thuongton999/openarm/apps/firmware/firmware.ioc

Mcu.UserName=STM32F103C8Tx
PA11.Signal=USB_DM
PA12.Signal=USB_DP
PA13.Signal=SYS_JTMS-SWDIO
PA14.Signal=SYS_JTCK-SWCLK
PB3.Signal=SYS_JTDO-TRACESWO
PB6.Signal=I2C1_SCL
PB7.Signal=I2C1_SDA
PC13-TAMPER-RTC.Signal=GPIO_Output
PD0-OSC_IN.Signal=RCC_OSC_IN
PD1-OSC_OUT.Signal=RCC_OSC_OUT
