thuongton999/openarm/(commit log)

2025-10-15 feat(joints): Enhance reset functionality to update robot model and send angles; refactor UI by removing unnecessary gap in ConnectButton
2025-10-15 chore(docs): Remove ENVIRONMENT_SETUP.md and add README.md for project overview, features, setup instructions, and deployment details; update CAD README for credential setup reference.
2025-10-30 feat(firmware): Add initial firmware structure with DMA, GPIO, I2C, and USB device support; include FreeRTOS configuration and protocol handling; update webconnect with new proto definitions and remo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
2025-11-05 feat(firmware): Implement PCA9685 PWM driver and Protocol Buffers integration for servo control; add FreeRTOS task management for command processing and safety monitoring; enhance USB CDC communicati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
2025-11-06 feat(firmware): Add servo channel definitions and implement varint decoding for protocol messages; refactor servo control tasks for improved clarity and safety monitoring.
2025-11-06 docs(README): Update project features and structure; add Protobuf integration details and modify firmware development instructions; update live demo link. feat(JointSliders): Adjust joint angle limit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
2025-11-08 feat(webconnect): Update environment configuration for CDN URLs; modify README and example files to reflect new R2 public URL structure; enhance joint control UI with IK mode toggle and improved join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
2025-11-10 feat(webconnect): Refactor IK functionality and UI components; implement IK state management with Svelte stores, enhance joint control with IK mode toggle, and update README with new documentation li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
    IMPORTANT: THERE IS A BUG IN WEB-UI, IK IS NOT COMPLETED YET
